vivekarora2000/Electronic-Voting-Machine/(list of files, drawings)

Other design files:
G54design.dsn
